dvillevald/Google-Vision-AIY-on-Wheels/images/Robot_with_ligths_on.jpg

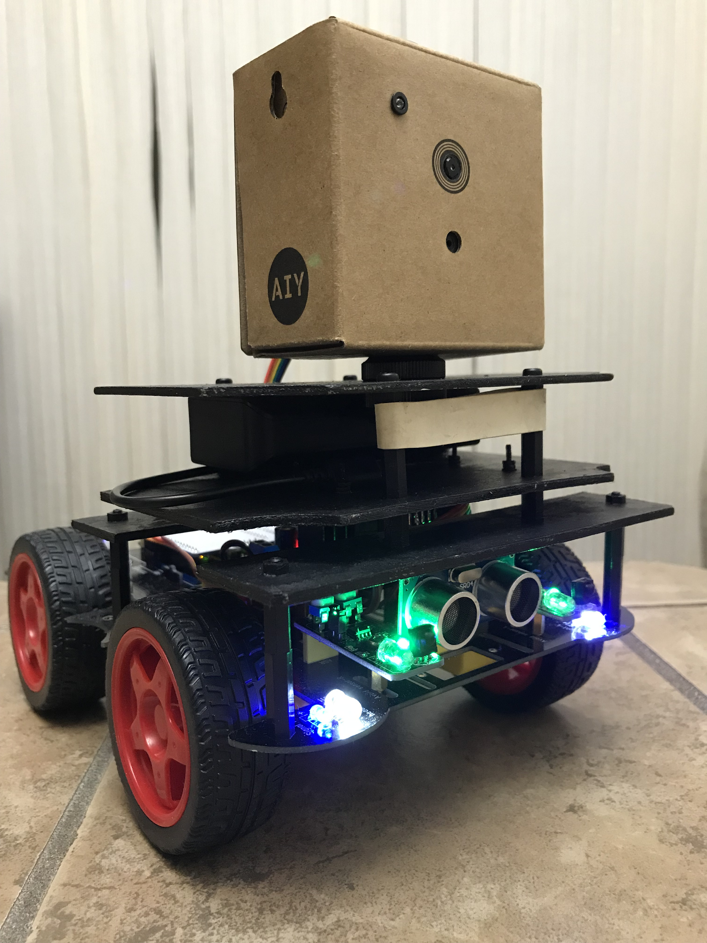
images/Robot_with_ligths_on.jpg
