dvillevald/Google-Vision-AIY-on-Wheels/arduino/UNIROI Robot Car Manual Page 1.jpg

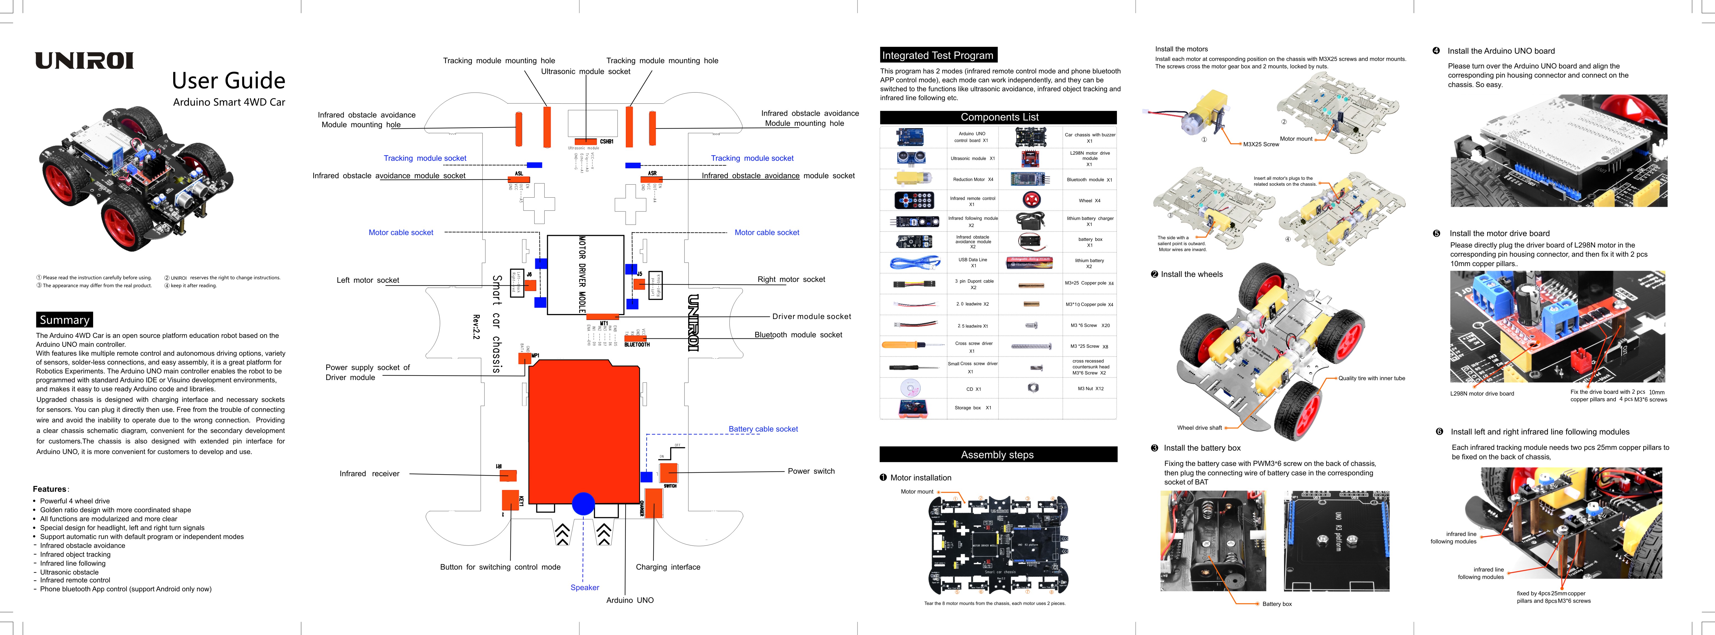
arduino/UNIROI Robot Car Manual Page 1.jpg
