dvillevald/Google-Vision-AIY-on-Wheels/arduino/UNIROI Robot Car Manual Page 2.jpg

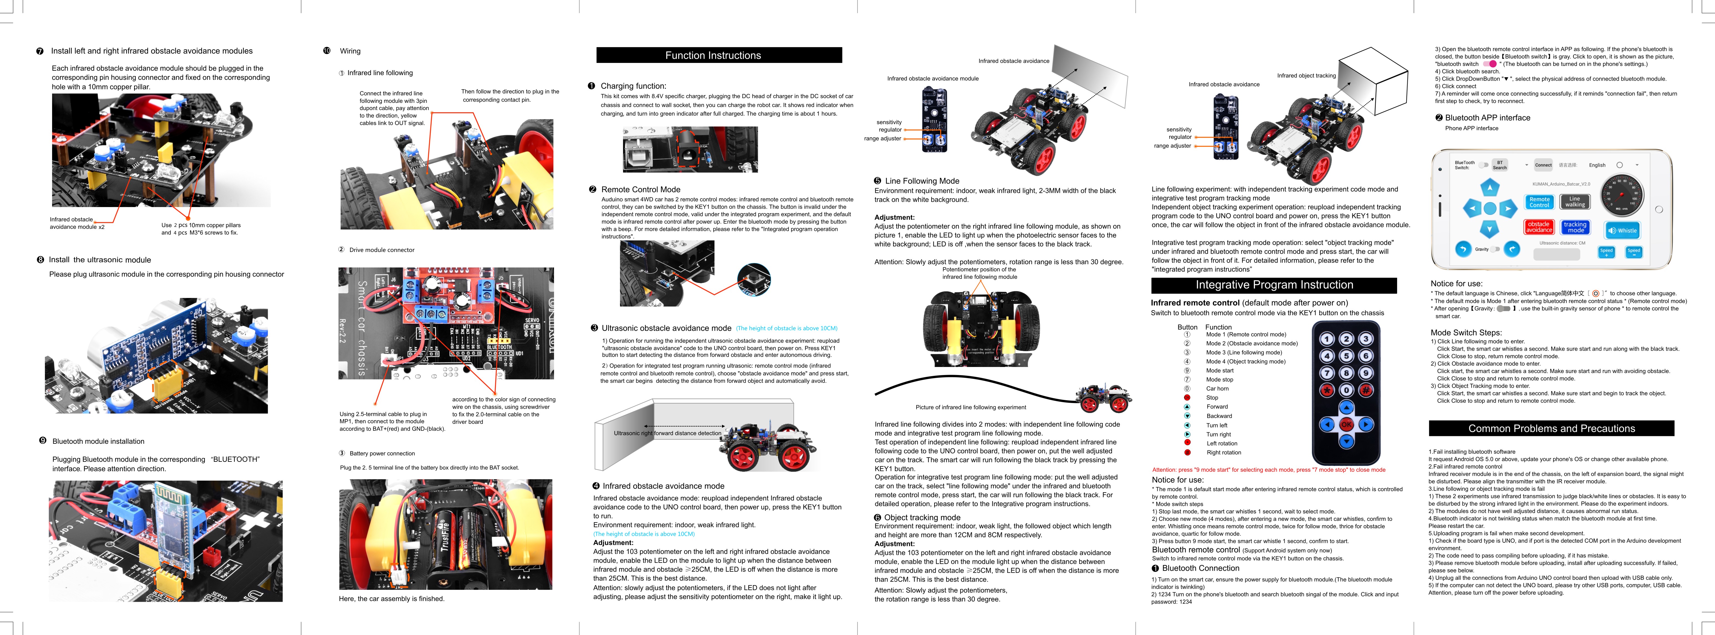
arduino/UNIROI Robot Car Manual Page 2.jpg
