dvillevald/Google-Vision-AIY-on-Wheels/arduino/UNIROI Arduino Robot Kit (Chassis Schematics).pdf

## MOTOR DRIVER POWER

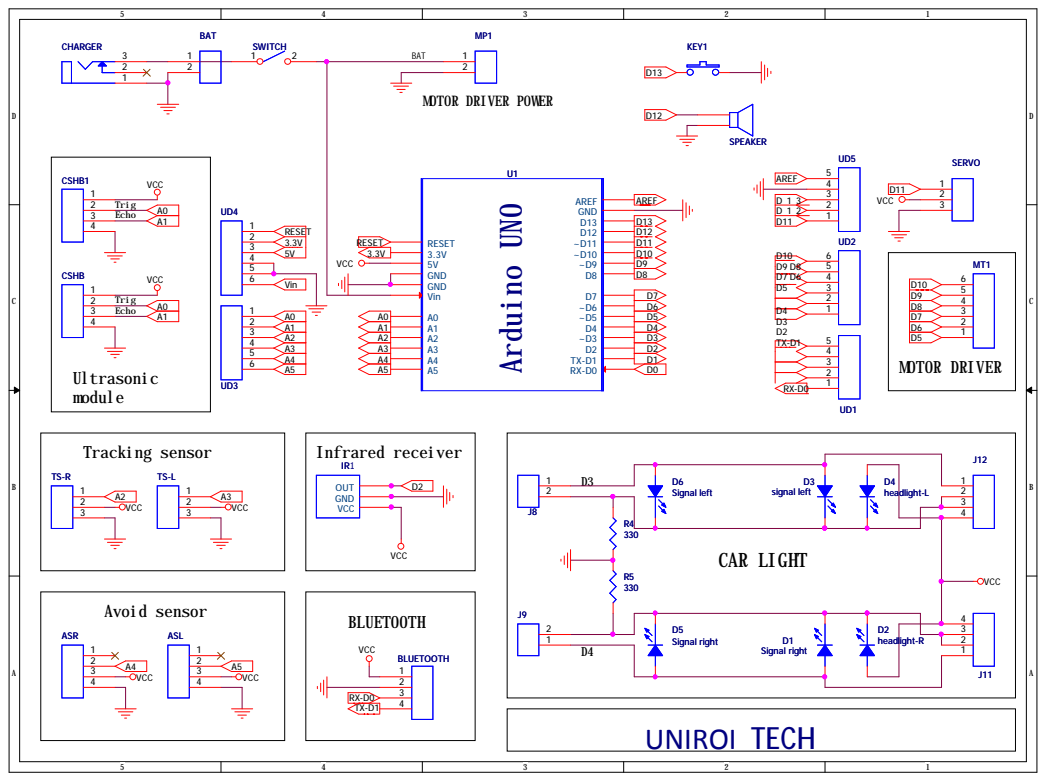
[picture p25: page 1]

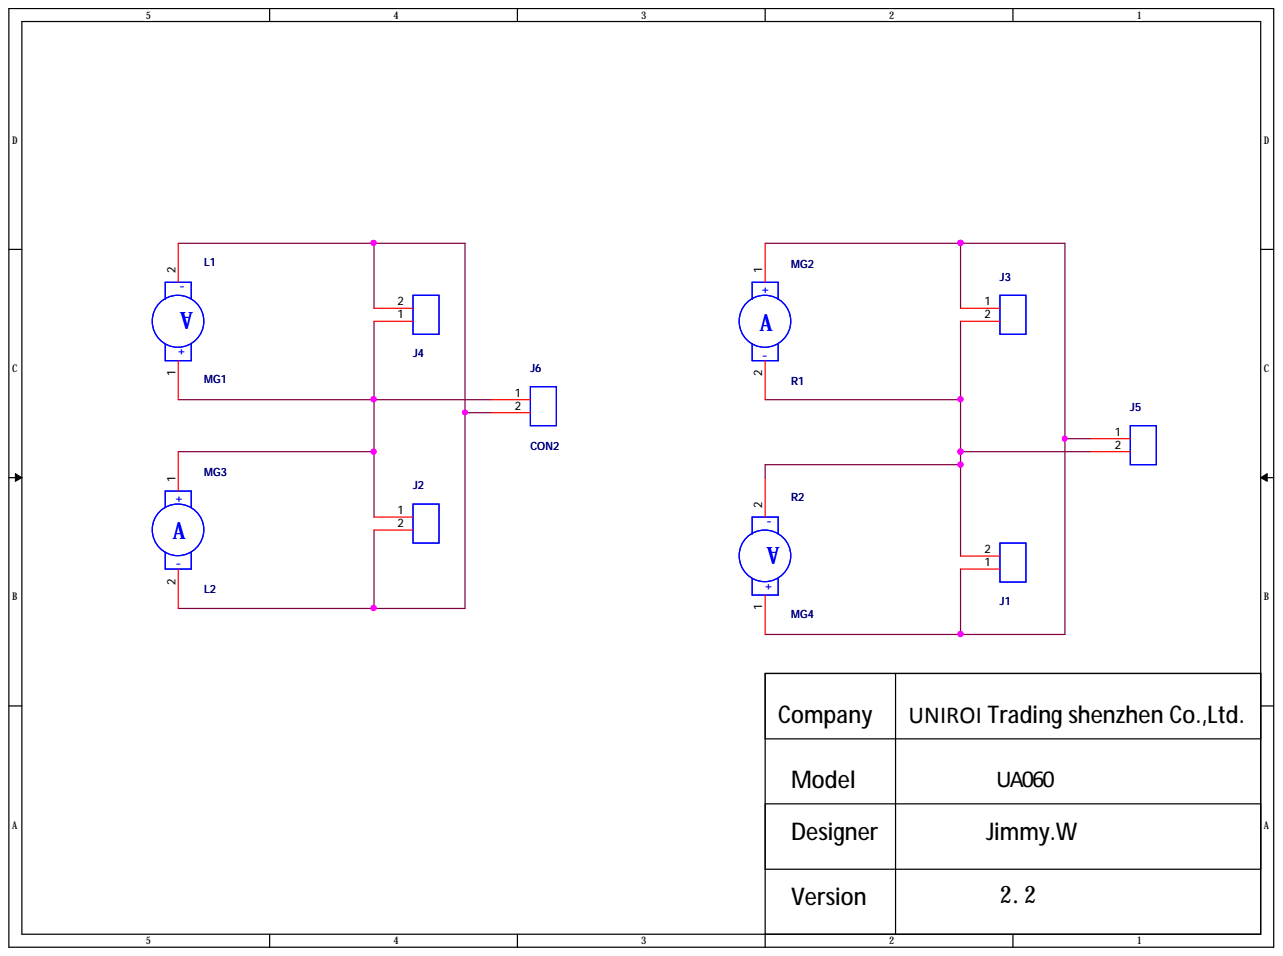
[picture p26: page 2]

UNIROI Trading shenzhen Co.,Ltd.
