dvillevald/Google-Vision-AIY-on-Wheels/arduino/UNIROI Arduino Robot kit (Arduino schematics).pdf

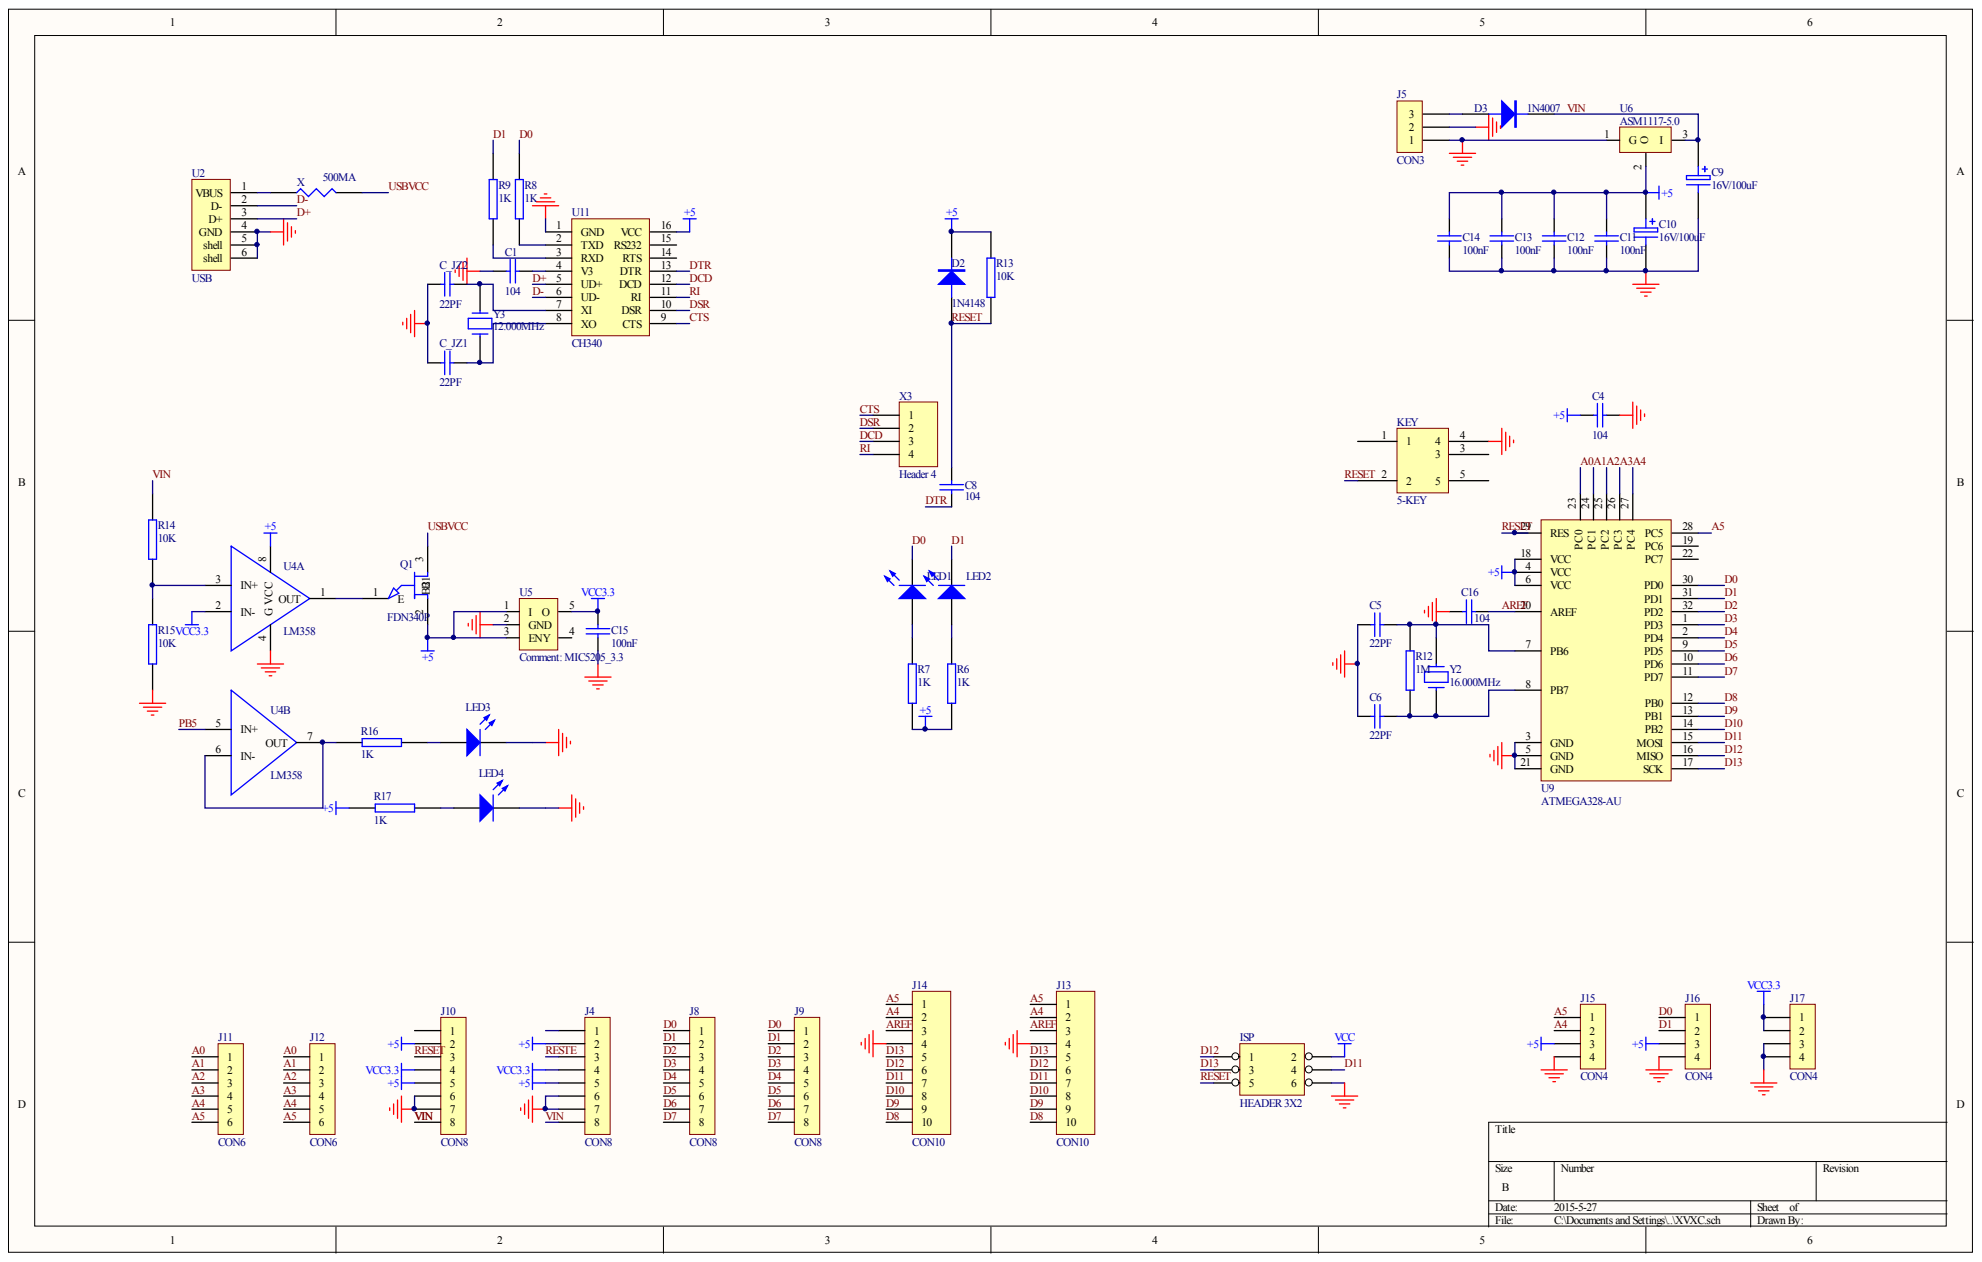
[picture p27: page 1]
